pochihh/Project-NUEVO/documents/README.md

# Documentation

Assembly instructions, course materials, and technical documentation.

## Contents
