pochihh/Project-NUEVO/nuevo_ui/frontend/src/assets/47b12eea5199a1312555fbe9149aeb89f102c11f.png

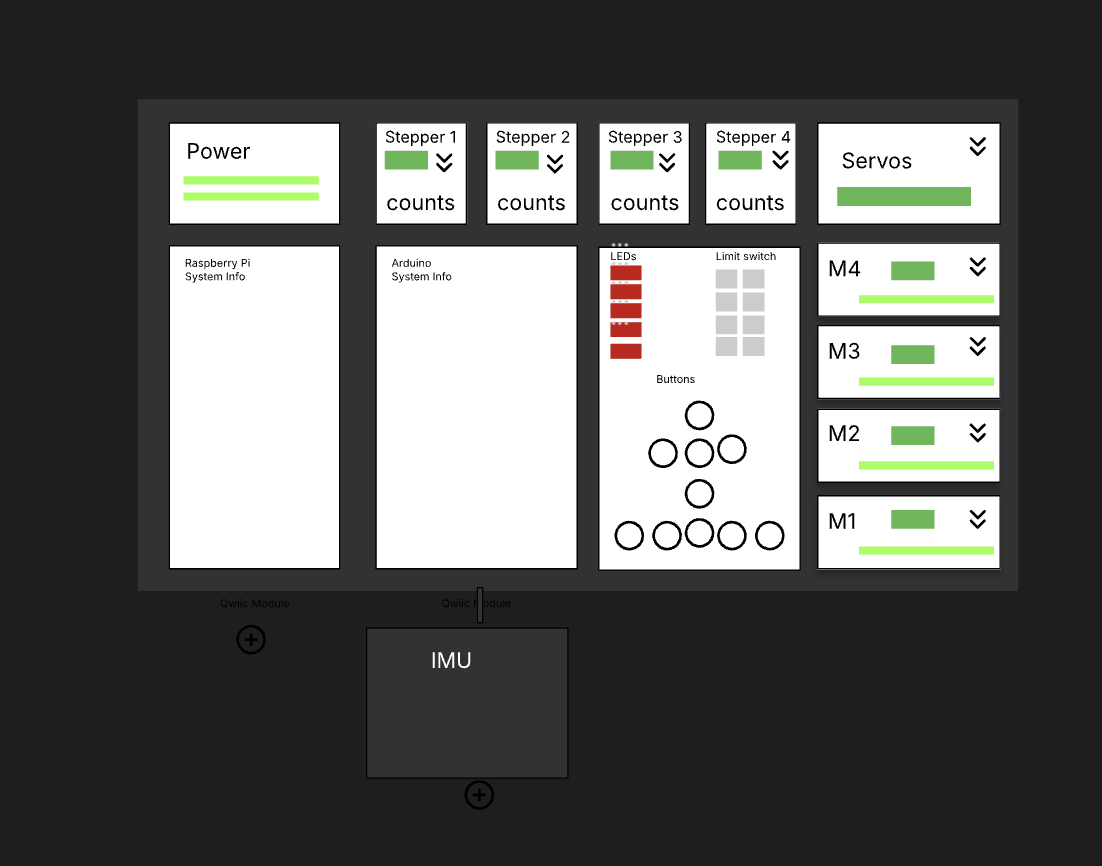
nuevo_ui/frontend/src/assets/47b12eea5199a1312555fbe9149aeb89f102c11f.png
