pochihh/Project-NUEVO/(list of files, drawings)

Other design files:
nuevo_board/project/NUEVO board Rev. B.epro
