pochihh/Project-NUEVO/(commit log)

2026-01-28 added UART test code in Python
2026-01-30 modified Arduino Pinouts; hardware verification needed
2026-02-10 added PCB project
    [ProPrj_162 Carrier Board_2026-02-10.epro]
2026-02-13 added current sensing test
2026-02-20 uploaded NUEVO board PCB
2026-02-25 created nuevo UI. More testing neede.
    [NUEVO board Rev. B.epro]
2026-02-25 upadted PCB folder name
    [NUEVO board Rev. B.epro]
2026-02-25 updated nuevo_baord
    [NUEVO board Rev. B.epro]
2026-02-26 removed duplicated files
    [NUEVO board Rev. B.epro]
2026-02-27 updated ui with login feature; seperated uart to a delicate thread for better prformance
2026-03-06 update ros2 env for pi camera
2026-03-22 fixed error and wanring logic
    [MessageCenter.cpp, SystemManager.cpp, SystemManager.h]
